Chaitanya110703/AxxSolder/PCB/AxxSolder/AxxSolder.kicad_pcb

## KiCad design PCB/AxxSolder/AxxSolder.kicad_pcb (2023-10-22)

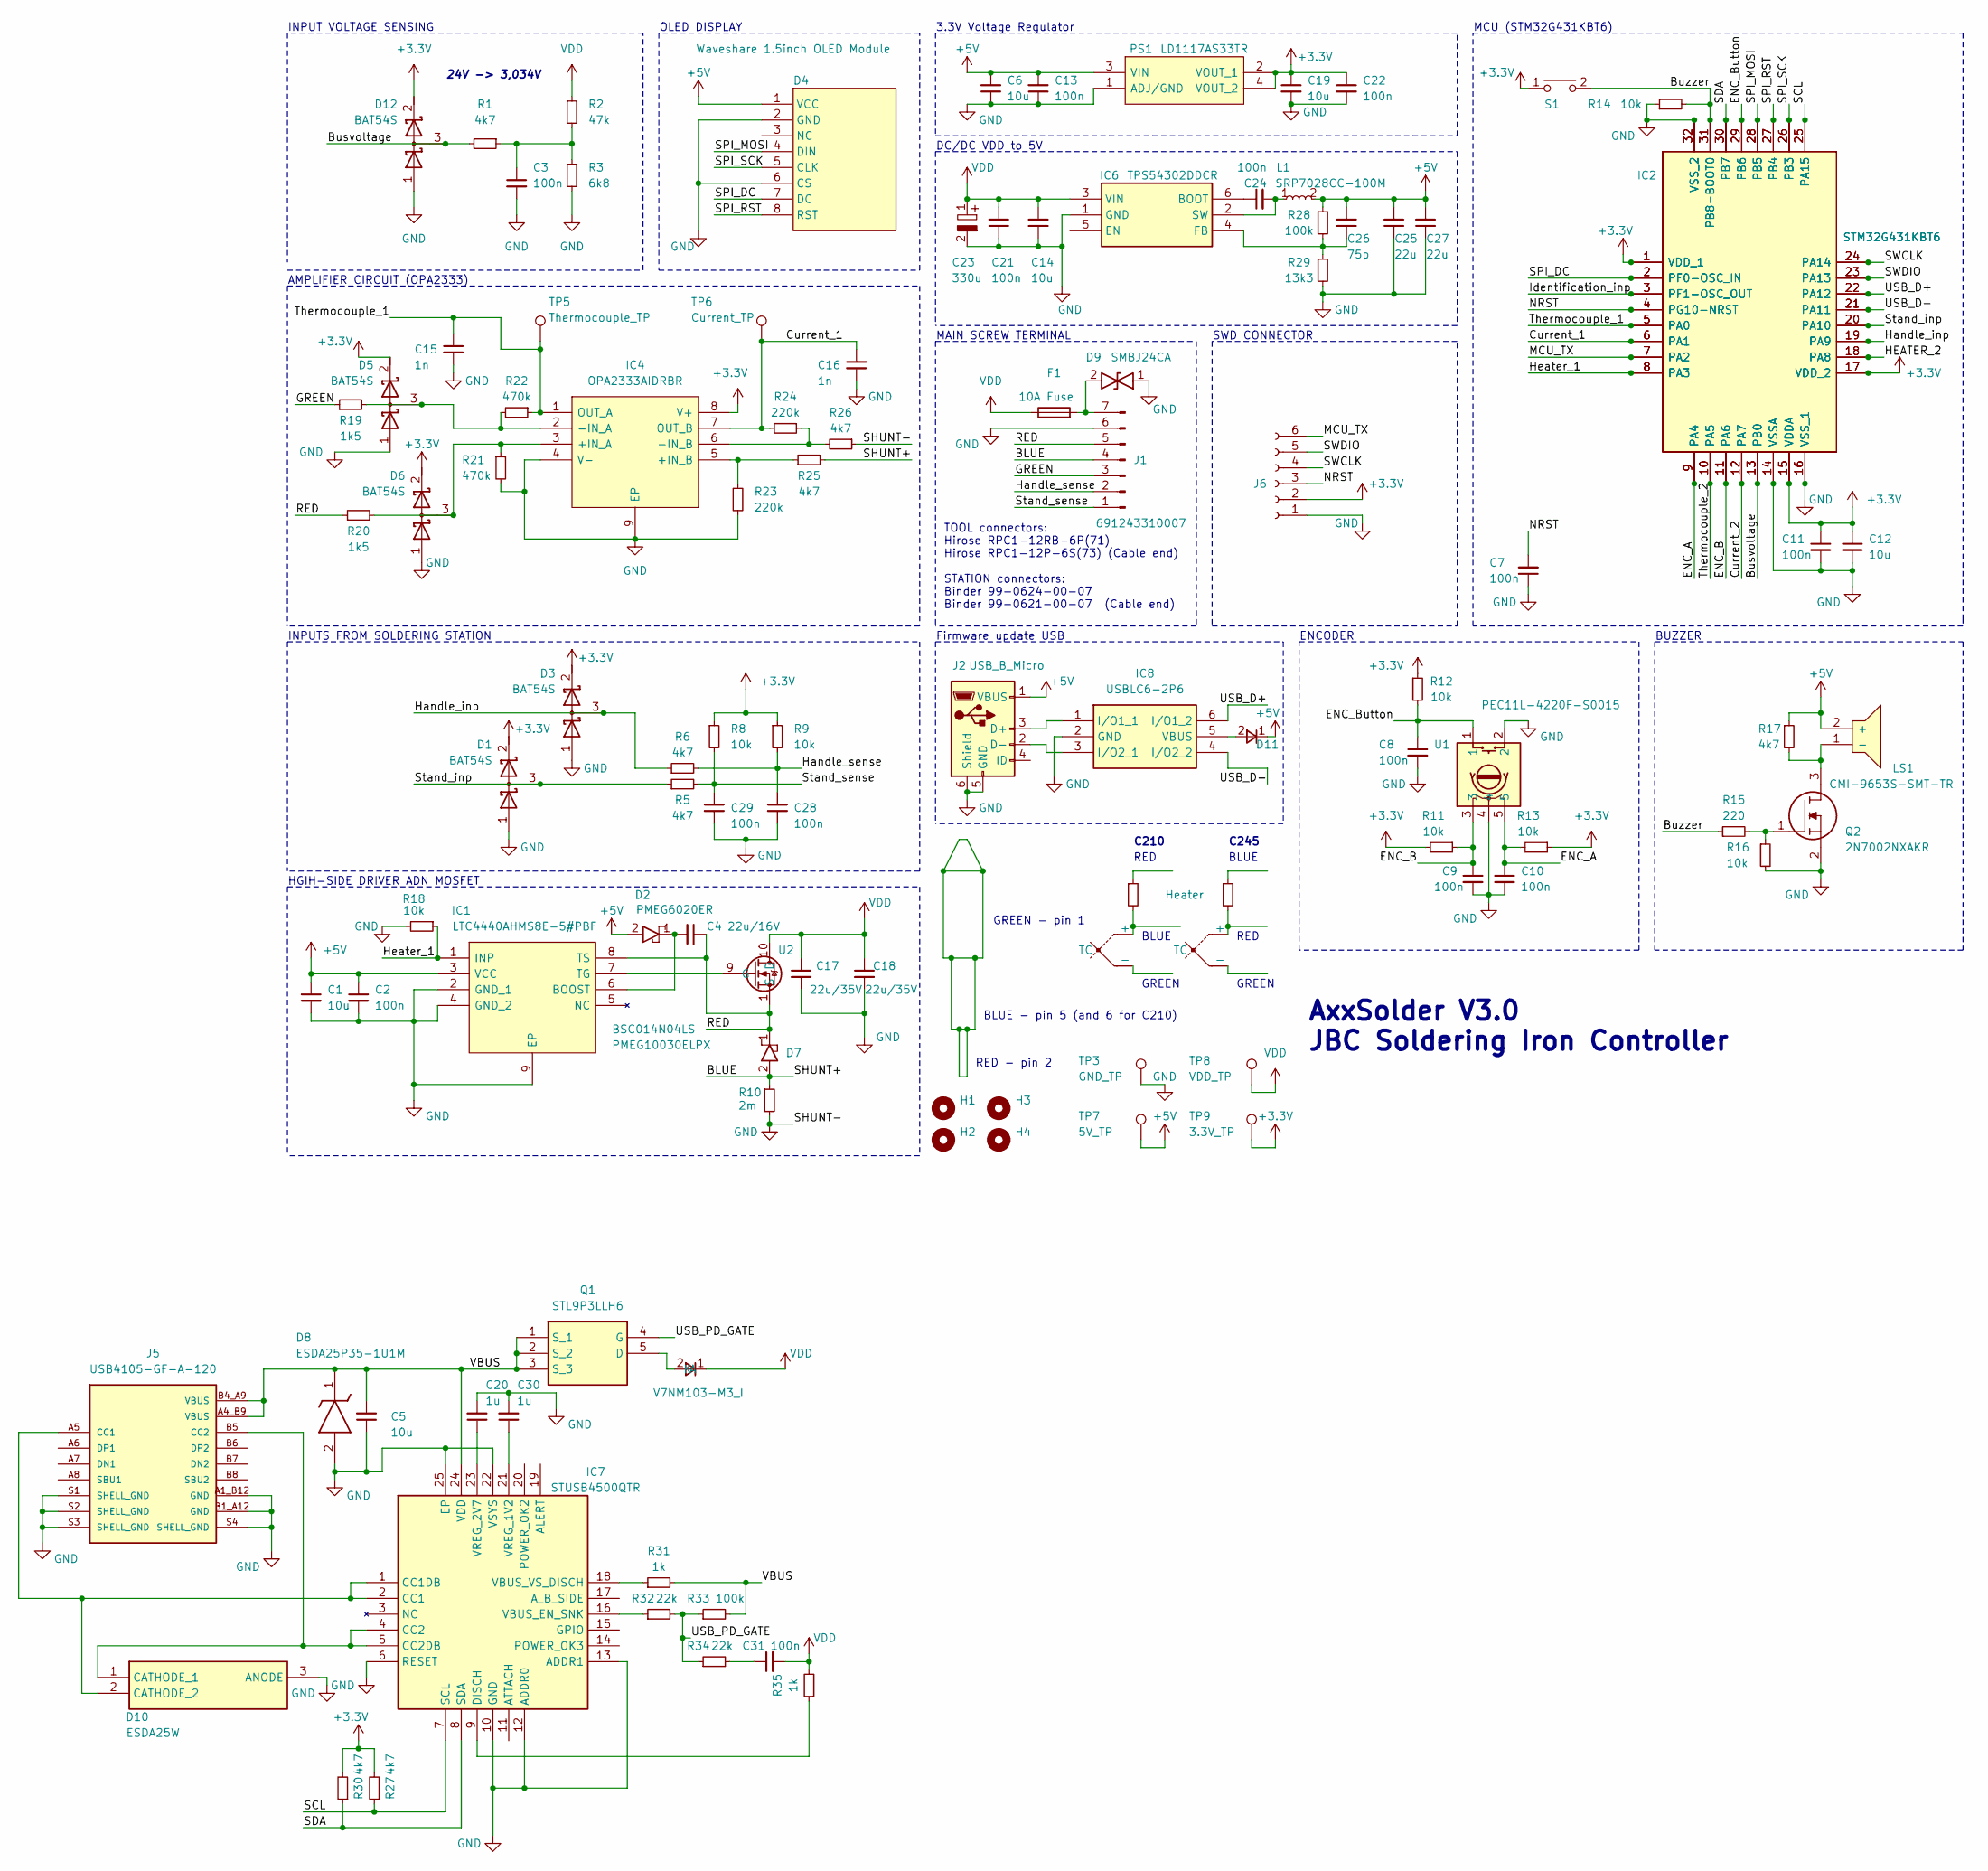
[picture p1: schematic AxxSolder.kicad_sch]

Parts:
C1, C5, C6, C12, C14, C19: 10u; C_0805_2012Metric
C2, C3, C7, C8, C9, C10, C11, C13, C21, C22, C24, C28, C29, C31: 100n; C_0805_2012Metric
C4: 22u/16V; C_1206_3216Metric
C15, C16: 1n; C_0805_2012Metric
C17, C18: 22u/35V; C_1206_3216Metric
C20, C30: 1u; C_0805_2012Metric
C23: 330u; CAPAE1030X1050N; Mouser Part Number 661-EMZR500ARA331MJA
C25, C27: 22u; C_1206_3216Metric
C26: 75p; C_0805_2012Metric
D1, D3, D5, D6, D12: BAT54S; SOT95P230X110-3N
D2: PMEG6020ER; PMEG6020ER115; Mouser Part Number 771-PMEG6020ER-115
D4: Waveshare 1.5inch OLED Module; 1_5inch-rgb-oled-module_asm-1110
D7: PMEG10030ELPX; SODFL4725X110N; Mouser Part Number 771-PMEG10030ELPX
D8: ESDA25P35-1U1M; ESDA25P351U1M; Mouser Part Number 511-ESDA25P35-1U1M
D9: SMBJ24CA; DIOM5436X261N; Mouser Part Number 576-SMBJ24CA
D10: ESDA25W; SOT65P210X110-3N; Mouser Part Number 511-ESDA25W
D11: 1N5819HW-7-F; SOD3716X145N; Mouser Part Number 621-1N5819HW-F
D13: V7NM103-M3_I; V7NM103M3I; Mouser Part Number 625-V7NM103-M3/I
F1: 10A Fuse; 3557-2
H1, H2, H3, H4: MountingHole; MountingHole_3mm
IC1: LTC4440AHMS8E-5#PBF; SOP65P490X110-9N; Mouser Part Number 584-C4440AHMS8E-5PBF
IC2: STM32G431KBT6; QFP80P900X900X160-32N; Mouser Part Number 511-STM32G431KBT6
IC4: OPA2333AIDRBR; SON65P300X300X100-9N-D; Mouser Part Number 595-OPA2333AIDRBR
IC5: STM32G431KBT6; UFQFPN-32-1EP_5x5mm_P0.5mm_EP3.5x3.5mm; Mouser Part Number 511-STM32G431KBT6
IC6: TPS54302DDCR; SOT95P280X110-6N; Mouser Part Number 595-TPS54302DDCR
IC7: STUSB4500QTR; QFN50P400X400X100-25N-D; Mouser Part Number 511-STUSB4500QTR
IC8: USBLC6-2P6; USBLC62P6; Mouser Part Number 511-USBLC6-2P6
J1: Conn_01x07_Male; 691243310007; Manufacturer_Part_Number 691243310007
J2: USB_B_Micro; GCT_USB3140-30-0230-1-C_REVE1
J5: USB4105-GF-A-120; GCT_USB4105-GF-A-120; PARTREV A3
J6: Conn_01x06_Socket; PinSocket_1x06_P2.54mm_Vertical
L1: SRP7028CC-100M; INDPM7366X300N; Manufacturer_Part_Number SRP7028CC-100M
LS1: CMI-9653S-SMT-TR; CMI9653SSMTTR; Mouser Part Number 490-CMI-9653S-SMT-TR
PS1: LD1117AS33TR; SOT230P700X190-4N; Mouser Part Number 511-LD1117AS33
Q1: STL9P3LLH6; STL20N6F7; Mouser Part Number 511-STL9P3LLH6
Q2: 2N7002NXAKR; SOT95P230X110-3N; Manufacturer_Part_Number 2N7002NXAKR; Mouser Part Number 771-2N7002NXAKR
R1, R5, R6, R17, R25, R26, R27, R30: 4k7; R_0805_2012Metric
R2: 47k; R_0805_2012Metric
R3: 6k8; R_0805_2012Metric
R4: Heater
R7: Heater 2 OHM
R8, R9, R11, R12, R13, R14, R16, R18: 10k; R_0805_2012Metric
R10: 2m; RESC6432X89N; part_id WSLP25122L500FEA
R15: 220; R_0805_2012Metric
R19, R20: 1k5; R_0805_2012Metric
R21, R22: 470k; R_0805_2012Metric
R23, R24: 220k; R_0805_2012Metric
R28, R33: 100k; R_0805_2012Metric
R29: 13k3; R_0805_2012Metric
R31, R35: 1k; R_0805_2012Metric
R32, R34: 22k; R_0805_2012Metric
S1: PTS636_SM43_SMTR_LFS; PTS636SM43SMTRLFS; Mouser Part Number 611-PTS636SM43SMTRLF
TC1, TC2: TC
TP3: GND_TP; TestPoint_THTPad_D1.0mm_Drill0.5mm
TP5: Thermocouple_TP; TestPoint_Pad_D1.0mm
TP6: Current_TP; TestPoint_Pad_D1.0mm
TP7: 5V_TP; TestPoint_THTPad_D1.0mm_Drill0.5mm
TP8: VDD_TP; TestPoint_THTPad_D1.0mm_Drill0.5mm
TP9: 3.3V_TP; TestPoint_THTPad_D1.0mm_Drill0.5mm
U1: PEC11L-4220F-S0015; PEC11L4220FS0015; Mouser Part Number 652-PEC11L4220FS0015
U2: BSC014N04LS

Connections:
+3.3V: C11.1, C12.1, C19.1, C22.1, D1.2 (K), D3.2 (K), D5.2 (K), D6.2 (K), D12.2 (K), IC2.1 (VDD_1), IC2.15 (VDDA), IC2.17 (VDD_2), IC4.8 (V+), IC5.1 (VDD_1), IC5.15 (VDDA), IC5.17 (VDD_2), J6.2, PS1.2 (VOUT_1), PS1.4 (VOUT_2), R8.1, R9.1, R11.2, R12.1, R13.1, R27.2, R30.2, S1.1, TP9.1
+5V: C1.1, C2.1, C6.2, C13.2, C25.2, C26.2, C27.2, D2.2, D4.1 (VCC), D11.1, IC1.3 (VCC), J2.1 (VBUS), L1.2, LS1.2 (+), PS1.3 (VIN), R17.1, R28.1, TP7.1
/BLUE: D7.2, J1.4, R10.1, R25.2
/Busvoltage: D12.3 (common), IC2.13 (PB0), IC5.13 (PB0), R1.2
/Buzzer: IC2.31 (PB8-BOOT0), IC5.31 (PB8-BOOT0), R14.2, R15.1, S1.2
/Current_1: C16.1, IC2.6 (PA1), IC4.7 (OUT_B), IC5.6 (PA1), R24.2, TP6.1
/Current_2: IC2.12 (PA7), IC5.12 (PA7)
/ENC_A: C10.1, IC2.9 (PA4), IC5.9 (PA4), R13.2, U1.5
/ENC_B: C9.1, IC2.11 (PA6), IC5.11 (PA6), R11.1, U1.3
/ENC_Button: C8.1, IC2.29 (PB6), IC5.29 (PB6), R12.2, U1.1
/GREEN: J1.3, R19.1
/HEATER_2: IC2.18 (PA8), IC5.18 (PA8)
/Handle_inp: D3.3 (common), IC2.19 (PA9), IC5.19 (PA9), R6.1
/Handle_sense: C28.1, J1.2, R6.2, R9.2
/Heater_1: IC1.1 (INP), IC2.8 (PA3), IC5.8 (PA3), R18.1
/Identification_inp: IC2.3 (PF1-OSC_OUT), IC5.3 (PF1-OSC_OUT)
/MCU_TX: IC2.7 (PA2), IC5.7 (PA2), J6.6
/NRST: C7.2, IC2.4 (PG10-NRST), IC5.4 (PG10-NRST), J6.3
/RED: C4.1, D7.1, IC1.8 (TS), J1.5, R20.1, U2.1 (S)
/SCL: IC2.25 (PA15), IC5.25 (PA15), IC7.7 (SCL), R27.1
/SDA: IC2.30 (PB7), IC5.30 (PB7), IC7.8 (SDA), R30.1
/SPI_DC: D4.7 (DC), IC2.2 (PF0-OSC_IN), IC5.2 (PF0-OSC_IN)
/SPI_MOSI: D4.4 (DIN), IC2.28 (PB5), IC5.28 (PB5)
/SPI_RST: D4.8 (RST), IC2.27 (PB4), IC5.27 (PB4)
/SPI_SCK: D4.5 (CLK), IC2.26 (PB3), IC5.26 (PB3)
/SWCLK: IC2.24 (PA14), IC5.24 (PA14), J6.4
/SWDIO: IC2.23 (PA13), IC5.23 (PA13), J6.5
/Stand_inp: D1.3 (common), IC2.20 (PA10), IC5.20 (PA10), R5.1
/Stand_sense: C29.1, J1.1, R5.2, R8.2
/Thermocouple_1: C15.1, IC2.5 (PA0), IC4.1 (OUT_A), IC5.5 (PA0), R22.1, TP5.1
/Thermocouple_2: IC2.10 (PA5), IC5.10 (PA5)
/USB_D+: IC2.22 (PA12), IC5.22 (PA12), IC8.6 (I/O1_2)
/USB_D-: IC2.21 (PA11), IC5.21 (PA11), IC8.4 (I/O2_2)
/USB_PD_GATE: Q1.4 (G), R32.2, R33.1, R34.1
/VBUS: C5.2, D8.1 (K), IC7.24 (VDD), J5.A4_B9 (VBUS), J5.B4_A9 (VBUS), Q1.1 (S_1), Q1.2 (S_2), Q1.3 (S_3), R31.2, R33.2
GND: C1.2, C2.2, C3.2, C5.1, C6.1, C7.1, C8.2, C9.2, C10.2, C11.2, C12.2, C13.1, C14.1, C15.2, C16.2, C17.2, C18.2, C19.2, C20.2, C21.1, C22.2, C23.2, C25.1, C27.1, C28.2, C29.2, C30.2, D1.1 (A), D3.1 (A), D4.2 (GND), D4.6 (CS), D5.1 (A), D6.1 (A), D8.2 (A), D9.1, D10.3 (ANODE), D12.1 (A), IC1.2 (GND_1), IC1.4 (GND_2), IC1.9 (EP), IC2.14 (VSSA), IC2.16 (VSS_1), IC2.32 (VSS_2), IC4.4 (V-), IC4.9 (EP), IC5.14 (VSSA), IC5.16 (VSS_1), IC5.32 (VSS_2), IC6.1 (GND), IC7.6 (RESET), IC7.10 (GND), IC7.12 (ADDR0), IC7.13 (ADDR1), IC7.22 (VSYS), IC7.25 (EP), IC8.2 (GND), J1.6, J2.5 (GND), J2.6 (Shield), J5.A1_B12 (GND), J5.B1_A12 (GND), J5.S1 (SHELL_GND), J5.S2 (SHELL_GND), J5.S3 (SHELL_GND), J5.S4 (SHELL_GND), J6.1, PS1.1 (ADJ/GND), Q2.2, R3.2, R10.2, R14.1, R16.2, R18.2, R21.2, R23.2, R26.1, R29.2, TP3.1, U1.2, U1.4
unnamed: C3.1, R1.1, R2.2, R3.1
unnamed: C31.1, R34.2
unnamed: D5.3 (common), IC4.2 (-IN_A), R19.2, R22.2
unnamed: D6.3 (common), IC4.3 (+IN_A), R20.2, R21.1
unnamed: D10.1 (CATHODE_1), IC7.4 (CC2), IC7.5 (CC2DB), J5.B5 (CC2)
unnamed: D10.2 (CATHODE_2), IC7.1 (CC1DB), IC7.2 (CC1), J5.A5 (CC1)
unnamed: D13.2 (A), Q1.5 (D)
unnamed: C4.2, D2.1, IC1.6 (BOOST)
unnamed: IC1.7 (TG), U2.9 (G)
unnamed: IC4.5 (+IN_B), R23.1, R25.1
unnamed: IC4.6 (-IN_B), R24.1, R26.2
unnamed: C24.1, IC6.6 (BOOT)
unnamed: C26.1, IC6.4 (FB), R28.2, R29.1
unnamed: C24.2, IC6.2 (SW), L1.1
unnamed: IC7.9 (DISCH), R35.1
unnamed: IC7.16 (VBUS_EN_SNK), R32.1
unnamed: IC7.18 (VBUS_VS_DISCH), R31.1
unnamed: C30.1, IC7.21 (VREG_1V2)
unnamed: C20.1, IC7.23 (VREG_2V7)
unnamed: IC8.1 (I/O1_1), J2.3 (D+)
unnamed: IC8.3 (I/O2_1), J2.2 (D-)
unnamed: D11.2, IC8.5 (VBUS)
unnamed: D9.2, F1.2, J1.7
unnamed: LS1.1 (-), Q2.3, R17.2
unnamed: Q2.1, R15.2, R16.1
unnamed: R4.2, TC1.1 (+)
unnamed: R7.2, TC2.1 (+)
VDD: C14.2, C17.1, C18.1, C21.2, C23.1, C31.2, D13.1 (K), F1.1, IC6.3 (VIN), R2.1, R35.2, TP8.1, U2.10 (D)

Notes on the sheet:
C210
Firmware update USB
MCU (STM32G431KBT6)
C245
GREEN - pin 1
MAIN SCREW TERMINAL
AMPLIFIER CIRCUIT (OPA2333)
24V -> 3,034V
INPUT VOLTAGE SENSING
ENCODER
SWD CONNECTOR
BLUE
BLUE - pin 5 (and 6 for C210)
GREEN
RED
BUZZER
DC/DC VDD to 5V
AxxSolder V3.0 JBC Soldering Iron Controller
TOOL connectors: Hirose RPC1-12RB-6P(71) Hirose RPC1-12P-6S(73) (Cable end) STATION connectors: Binder 99-0624-00-07 Binder 99-0621-00-07 (Cable end)
INPUTS FROM SOLDERING STATION
HGIH-SIDE DRIVER ADN MOSFET
RED - pin 2
RED
3.3V Voltage Regulator
OLED DISPLAY

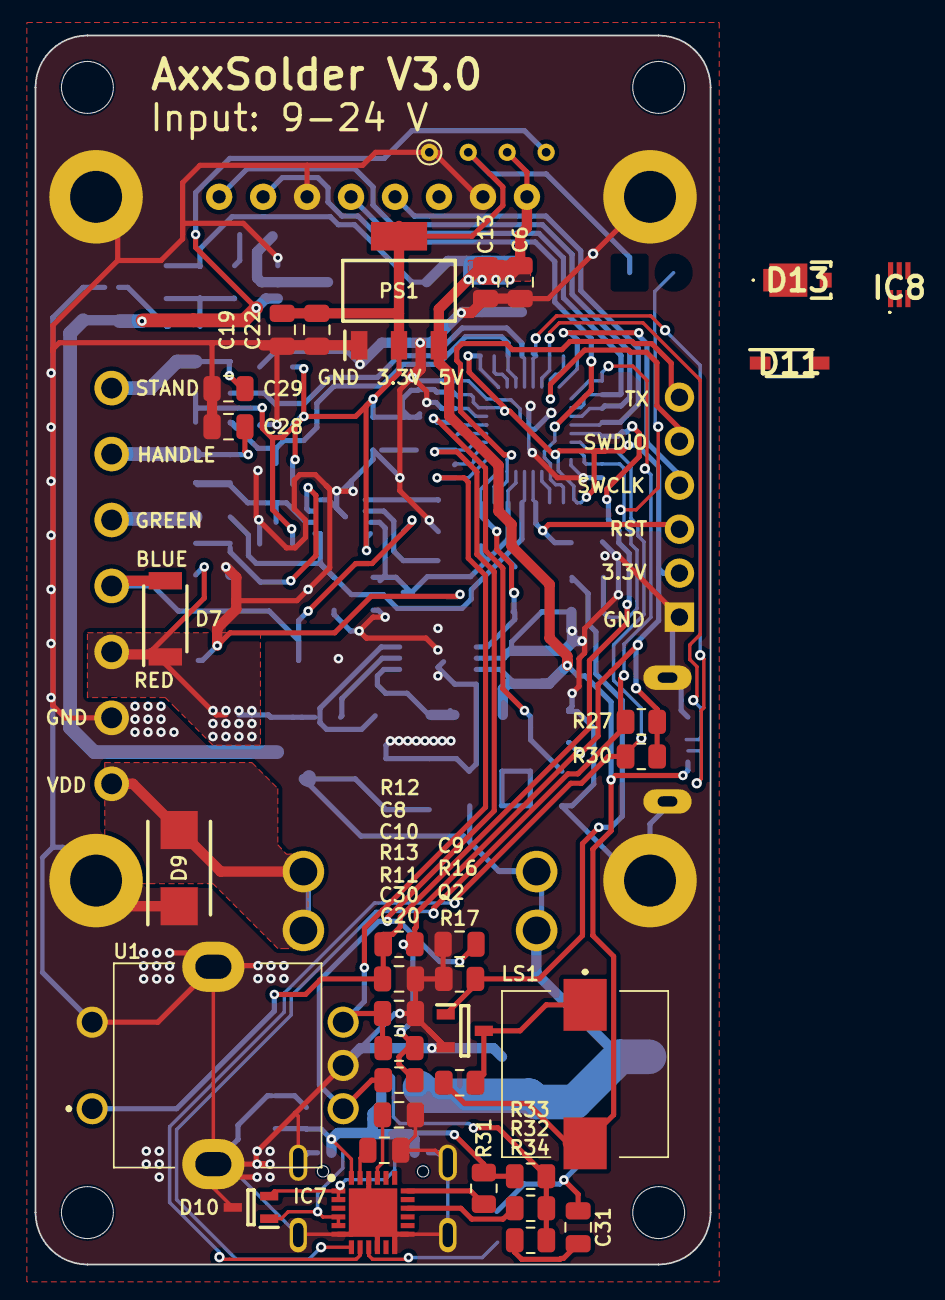
[picture p2: board AxxSolder.kicad_pcb from above]

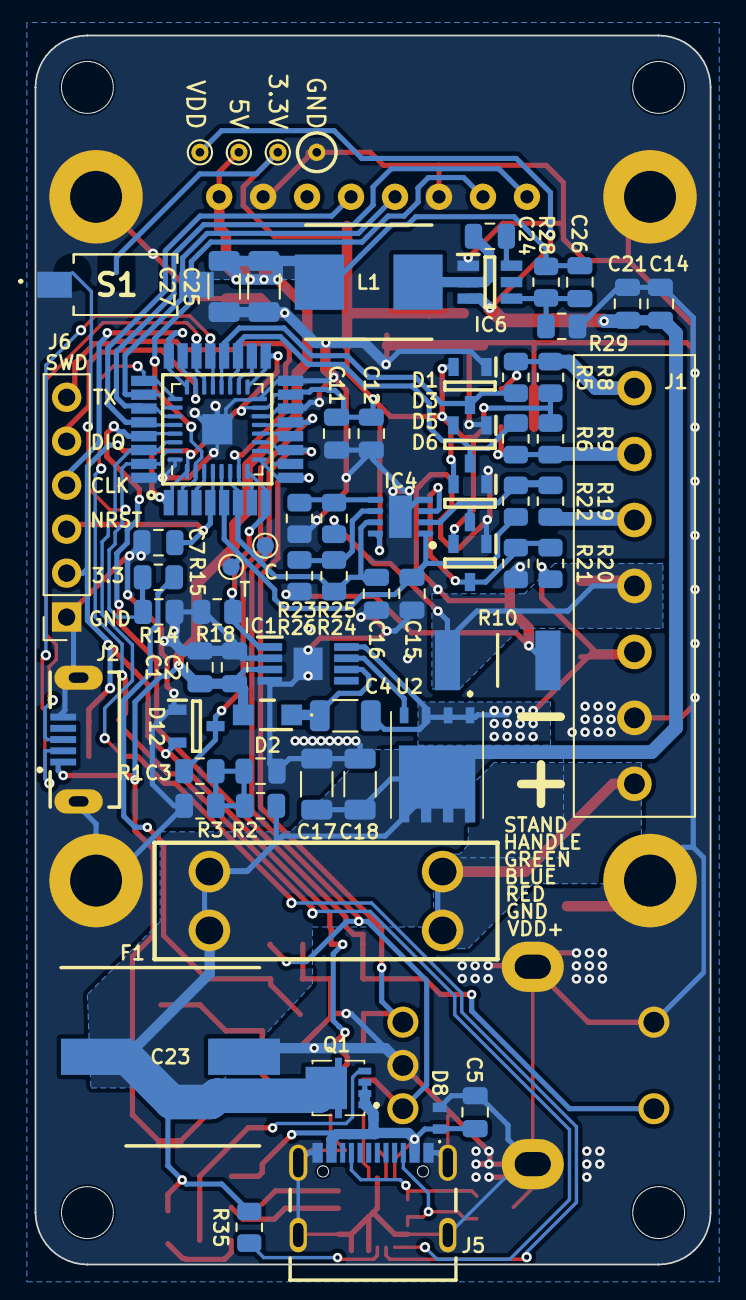
[picture p3: board AxxSolder.kicad_pcb from below]

Board: 2 copper layers, 39.0 x 71.0 mm, 107 parts (68 on the bottom side), 62 nets.
