Chaitanya110703/AxxSolder/Software/AxxSolder/Core/Src/main.c

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
/* Includes ------------------------------------------------------------------*/
#include "main.h"

/* USER CODE BEGIN Includes */
#include "string.h"
#include "OLED_1in5.h"
#include "test.h"
#include "pid.h"
#include "moving_average.h"
/* USER CODE END Includes */

/* USER CODE BEGIN PTD */

#define version "2.2.0"

enum handles {
	T210,
	T245
} handle;

uint8_t beep_requested = 0;							/* Bool to handle beep signal triggered by interrupt */

/* Create a new image cache */
UBYTE *black_image;
UWORD image_size = ((OLED_1in5_WIDTH%2==0)? (OLED_1in5_WIDTH/2): (OLED_1in5_WIDTH/2+1)) * OLED_1in5_HEIGHT;

/* Timing constants */
uint32_t previous_millis_display = 0;
uint32_t interval_display = 25;

uint32_t previous_millis_debug = 0;
uint32_t interval_debug = 50;

uint32_t previous_millis_PID_update = 0;
uint32_t interval_PID_update = 50;

uint32_t previous_millis_HANDLE_update = 0;
uint32_t interval_HANDLE_update = 200;

uint32_t previous_millis_heating_halted_update = 0;
uint32_t interval_heating_halted_update = 500;

uint32_t previous_millis_left_stand = 0;
uint32_t EMERGENCY_shutdown_time = 1800000; 	//30 minutes
uint32_t EMERGENCY_shutdown_temperature = 475;  //475 Deg C

/* states for runtime switch */
typedef enum {
    RUN,
	SLEEP,
	EMERGENCY_SLEEP,
	HALTED,
} mainstates;
mainstates active_state = SLEEP;

/* Custom tuning parameters */
double Kp_custom = 0;
double Ki_custom = 0;
double Kd_custom = 0;
double temperature_custom = 100;

/* PID tuning parameters */
double Kp = 0;
double Ki = 0;
double Kd = 0;

char buffer[40];								/* Buffer for UART print */
uint8_t tx_done = 1;

#define POWER_REDUCTION_FACTOR 0.12 			/* Converts power in W to correct duty cycle */
float max_power_watt = 0.0; 					/* Sets the maximum output power */

float ADC_filter_mean = 0.0; 					/* Filtered ADC reading value */
#define ADC_BUF_LEN 400
uint16_t ADC_buffer[ADC_BUF_LEN];

#define VOLTAGE_COMPENSATION 0.00648678945 		/* Constant for scaling input voltage ADC value*/

#define MIN_SELECTABLE_TEMPERTURE 20
#define MAX_SELECTABLE_TEMPERTURE 450

/* TC Compensation constants */
#define TC_COMPENSATION_X3_T210 -6.798689261365103e-09
#define TC_COMPENSATION_X2_T210 -6.084684965926526e-06
#define TC_COMPENSATION_X1_T210 0.2710175613404393
#define TC_COMPENSATION_X0_T210 25.398999666765054

#define TC_COMPENSATION_X3_T245 2.0923844111330006e-09
#define TC_COMPENSATION_X2_T245 -1.2139133328964936e-05
#define TC_COMPENSATION_X1_T245 0.11753371673595008
#define TC_COMPENSATION_X0_T245 25.051871505499836


#define AMBIENT_TEMP_COMPENSATION 0.0008058608 /* Ambient temperature compensation constant 3.3/4095 */

/* Struct to hold sensor values */
struct sensor_values_struct {
	double set_temperature;
	double actual_temperature;
	float bus_voltage;
	float pcb_temperature;
	float ambient_temperature;
	double in_stand;
	double handle_sense;
	mainstates previous_state;
	uint8_t button_pressed;
	uint8_t button_read;
};

struct sensor_values_struct sensor_values  = {.set_temperature = 0.0,
        									.actual_temperature = 0.0,
											.bus_voltage = 0.0,
											.pcb_temperature = 0.0,
											.ambient_temperature = 0.0,
											.in_stand = 0.0,
											.handle_sense  = 0.0,
											.previous_state = SLEEP,
											.button_pressed = 0,
											.button_read = 0};

double PID_output = 0.0;
double PID_setpoint = 0.0;

/* Moving average filters for sensor data */
FilterTypeDef actual_temperature_filter_struct;
FilterTypeDef ambient_temperature_filter_struct;
FilterTypeDef input_voltage_filterStruct;
FilterTypeDef stand_sense_filterStruct;
FilterTypeDef handle_sense_filterStruct;

/* USER CODE END PTD */

 ADC_HandleTypeDef hadc1;
ADC_HandleTypeDef hadc2;
DMA_HandleTypeDef hdma_adc1;

I2C_HandleTypeDef hi2c1;

SPI_HandleTypeDef hspi1;

TIM_HandleTypeDef htim1;
TIM_HandleTypeDef htim2;
TIM_HandleTypeDef htim3;
TIM_HandleTypeDef htim8;
TIM_HandleTypeDef htim16;
TIM_HandleTypeDef htim17;

UART_HandleTypeDef huart2;

PCD_HandleTypeDef hpcd_USB_FS;

void SystemClock_Config(void);
static void MX_GPIO_Init(void);
static void MX_DMA_Init(void);
static void MX_TIM2_Init(void);
static void MX_SPI1_Init(void);
static void MX_ADC1_Init(void);
static void MX_TIM17_Init(void);
static void MX_USART2_UART_Init(void);
static void MX_TIM3_Init(void);
static void MX_TIM16_Init(void);
static void MX_I2C1_Init(void);
static void MX_ADC2_Init(void);
static void MX_TIM1_Init(void);
static void MX_TIM8_Init(void);
static void MX_USB_PCD_Init(void);
/* USER CODE BEGIN 0 */

PID_TypeDef TPID;

void HAL_UART_TxCpltCallback(UART_HandleTypeDef *UartHandle){
	/* Set transmission flag: transfer complete */
	tx_done = 1;
}

/* Returns the average of 100 readings of the index+4*n value in the ADC_buffer vector */
float get_mean_ADC_reading(uint8_t index){
	ADC_filter_mean = 0;
	for(int n=index;n<400;n=n+4){
		ADC_filter_mean += ADC_buffer[n];
	}
	return ADC_filter_mean/100.0;
}

void get_bus_voltage(){
	/* Index 3 is bus Voltage */
	sensor_values.bus_voltage = Moving_Average_Compute(get_mean_ADC_reading(3), &input_voltage_filterStruct)*VOLTAGE_COMPENSATION; /* Moving average filter */
}

void get_actual_temperature(){
	/* Index 0 is bus Voltage */
	float TC_temperature_temp = Moving_Average_Compute(get_mean_ADC_reading(0), &actual_temperature_filter_struct); /* Moving average filter */
	if(handle == T210){
		sensor_values.actual_temperature = pow(TC_temperature_temp, 3)*TC_COMPENSATION_X3_T210 +
				pow(TC_temperature_temp, 2)*TC_COMPENSATION_X2_T210 + TC_temperature_temp*TC_COMPENSATION_X1_T210 + TC_COMPENSATION_X0_T210;
	}
	else if(handle == T245){
		sensor_values.actual_temperature = pow(TC_temperature_temp, 3)*TC_COMPENSATION_X3_T245 +
				pow(TC_temperature_temp, 2)*TC_COMPENSATION_X2_T245 + TC_temperature_temp*TC_COMPENSATION_X1_T245 + TC_COMPENSATION_X0_T245;
	}

	if(sensor_values.actual_temperature > 999){
		sensor_values.actual_temperature = 999;
	}
}

void get_ambient_temp(){
	//Index 2 is PCB temp
	/* Moving average filter */
	sensor_values.ambient_temperature = ((Moving_Average_Compute(get_mean_ADC_reading(2), &ambient_temperature_filter_struct)*AMBIENT_TEMP_COMPENSATION)-0.4)/0.0195;
	//• Positive slope sensor gain, offset (typical):
	//– 19.5 mV/°C, 400 mV at 0°C (TMP236-Q1) From data sheet
}

void debugPrint(UART_HandleTypeDef *huart, char _out[]){
    tx_done = 0;
	HAL_UART_Transmit_IT(huart, (uint8_t *) _out, strlen(_out));
	while(!tx_done);
}

/* Initiate OLED display */
void init_OLED(){
	OLED_1in5_Init();
	Driver_Delay_ms(500);
	OLED_1in5_Clear();

	//0.Create a new image cache
	if((black_image = (UBYTE *)malloc(image_size)) == NULL) {
		return;
	}
	Paint_NewImage(black_image, OLED_1in5_WIDTH, OLED_1in5_HEIGHT, 270, BLACK);
	Paint_SetScale(16);

	//1.Select Image
	Paint_SelectImage(black_image);
	Paint_Clear(BLACK);
	Driver_Delay_ms(200);
}

void update_OLED(){
	Paint_DrawString_EN(0, 0, " AxxSolder ", &Font16, 0x00, 0xff);
    Paint_DrawLine(0, 16, 127, 16, WHITE , 2, LINE_STYLE_SOLID);

	Paint_DrawString_EN(3, 20, "Set temp", &Font16, 0x00, 0xff);
	memset(&buffer, '\0', sizeof(buffer));
	sprintf(buffer, "%.f", sensor_values.set_temperature);
	Paint_DrawString_EN(3, 32, buffer, &Font24,  0x0, 0xff);
	Paint_DrawCircle(67, 37, 2, WHITE, 1, DRAW_FILL_EMPTY);
	Paint_DrawString_EN(70, 32, "C", &Font24,  0x0, 0xff);

	Paint_DrawString_EN(3, 58, "Act temp", &Font16, 0x00, 0xff);
	memset(&buffer, '\0', sizeof(buffer));

	if(sensor_values.actual_temperature >= 500){
		Paint_DrawString_EN(3, 70, "---", &Font24, 0x0, 0xff);
	}
	else{
		sprintf(buffer, "%.f", sensor_values.actual_temperature);
		Paint_DrawString_EN(3, 70, buffer, &Font24, 0x0, 0xff);
	}

	Paint_DrawCircle(67, 75, 2, WHITE, 1, DRAW_FILL_EMPTY);
	Paint_DrawString_EN(70, 70, "C", &Font24, 0x0, 0xff);
	Paint_DrawRectangle(1, 56, 100, 93 , WHITE, DOT_PIXEL_1X1, DRAW_FILL_EMPTY);

	Paint_DrawString_EN(0, 96, "HANDLE:", &Font12, 0x00, 0xff);
	if(handle == T210){
		Paint_DrawString_EN(60, 96, "T210", &Font12, 0x00, 0xff);
	}
	else if(handle == T245){
		Paint_DrawString_EN(60, 96, "T245", &Font12, 0x00, 0xff);
	}

	Paint_DrawString_EN(0, 109, "INPUT VOLTAGE:", &Font8, 0x00, 0xff);
	Paint_DrawString_EN(0, 118, "AMB TEMP:     POWER ->", &Font8, 0x00, 0xff);

	memset(&buffer, '\0', sizeof(buffer));
	sprintf(buffer, "%.1f", sensor_values.bus_voltage);
	Paint_DrawString_EN(75, 109, buffer, &Font8, 0x0, 0xff);

	memset(&buffer, '\0', sizeof(buffer));
	sprintf(buffer, "%.1f", sensor_values.ambient_temperature);
	Paint_DrawString_EN(45, 118, buffer, &Font8, 0x0, 0xff);

	Paint_DrawRectangle(116, 25, 128, 128, WHITE, DOT_PIXEL_1X1, DRAW_FILL_EMPTY);
	if(active_state == SLEEP || active_state == EMERGENCY_SLEEP || active_state == HALTED){
		Paint_DrawString_EN(116, 30,  "Z", &Font16, 0x00, 0xff);
		Paint_DrawString_EN(116, 50,  "z", &Font16, 0x00, 0xff);
		Paint_DrawString_EN(116, 70,  "Z", &Font16, 0x00, 0xff);
		Paint_DrawString_EN(116, 90,  "z", &Font16, 0x00, 0xff);
		Paint_DrawString_EN(116, 110, "z", &Font16, 0x00, 0xff);
	}
	else{
		Paint_DrawRectangle(116, 125-PID_output/10, 128, 128, WHITE, DOT_PIXEL_1X1, DRAW_FILL_FULL);
	}
	// Show image on page
	OLED_1in5_Display(black_image);
	Paint_Clear(BLACK);
}

/* Get encoder value (Set temp.) and limit is NOT heating_halted*/
void get_set_temperature(){
	if (TIM3->CNT <= MIN_SELECTABLE_TEMPERTURE) {TIM3->CNT = MIN_SELECTABLE_TEMPERTURE; }
	if (TIM3->CNT >= MAX_SELECTABLE_TEMPERTURE) {TIM3->CNT = MAX_SELECTABLE_TEMPERTURE; }
	sensor_values.set_temperature = TIM3->CNT;
}

/* Beep the buzzer for beep_time_ms */
void beep_ms(uint16_t beep_time_ms){
	TIM2->CCR1 = 50;
  	HAL_Delay(beep_time_ms);
  	TIM2->CCR1 = 0;
}

/* Create a beep is beep is requested */
void check_beep(){
	if(beep_requested){
		beep_ms(5);
		beep_requested = 0;
	}
}

/* Function to set state to EMERGENCY_SLEEP */
void check_emergency_shutdown(){
	/* Function to set state to EMERGENCY_SLEEP if iron is in RUN state for longer than EMERGENCY_shutdown_time */
	if(!sensor_values.previous_state == RUN  && active_state == RUN){
		previous_millis_left_stand = HAL_GetTick();
	}
	if ((sensor_values.in_stand == 0) && (HAL_GetTick() - previous_millis_left_stand >= EMERGENCY_shutdown_time) && active_state == RUN){
		active_state = EMERGENCY_SLEEP;
		beep_requested = 1;
	}
	sensor_values.previous_state = active_state;

	/* Function to set state to EMERGENCY_SLEEP if iron is over 500 deg C */
	if((sensor_values.actual_temperature > EMERGENCY_shutdown_temperature) && (active_state == RUN)){
		active_state = EMERGENCY_SLEEP;
		beep_requested = 1;
	}
}

/* Function to toggle between RUN and HALTED at each press of the encoder button */
void get_button_status(){
	if ((sensor_values.button_pressed == 1) && (sensor_values.button_read == 0)){
		sensor_values.button_read = 1;
		beep_requested = 1;
		// toggle between RUN and HALTED
		if (active_state == RUN){
			active_state = HALTED;
		}
		else if (active_state == HALTED){
			active_state = RUN;
		}
		else if (active_state == EMERGENCY_SLEEP){
			active_state = RUN;
		}
		previous_millis_heating_halted_update = HAL_GetTick();
	}
	if ((sensor_values.button_read == 1) && (HAL_GetTick()-previous_millis_heating_halted_update >= interval_heating_halted_update)){
		sensor_values.button_pressed = 0;
		sensor_values.button_read = 0;
	}
}

/* Get the status of handle in/on stand to trigger SLEEP */
void get_stand_status(){
	uint8_t stand_status;
	if(HAL_GPIO_ReadPin (GPIOA, STAND_INP_Pin) == 0){
		stand_status = 1;
	}
	else{
		stand_status = 0;
	}
	sensor_values.in_stand = Moving_Average_Compute(stand_status, &stand_sense_filterStruct); /* Moving average filter */

	/* If handle is in stand set state to SLEEP */
	if(sensor_values.in_stand > 0.5){
		active_state = SLEEP;
	}

	/* If handle is NOT in stand and state is SLEEP, change state to RUN */
	if((sensor_values.in_stand < 0.5) && (active_state == SLEEP)){
		active_state = RUN;
	}
}

/* Automatically detect handle type, T210 or T245 based on HANDLE_DETECTION_Pin, which is connected to BLUE for T210.*/
void get_handle_type(){
	uint8_t handle_status;
	if(HAL_GPIO_ReadPin (GPIOA, HANDLE_INP_Pin) == 0){
		handle_status = 1;
	}
	else{
		handle_status = 0;
	}
	sensor_values.handle_sense = Moving_Average_Compute(handle_status, &handle_sense_filterStruct); /* Moving average filter */

	/* If the handle_sense is high -> T210 handle is detected */
	if(sensor_values.handle_sense > 0.5){
		handle = T210;
		max_power_watt = 60; //60W
		Kp = 20;
		Ki = 60;
		Kd = 0.5;
	}
	/* If the handle_sense is low -> T245 Handle */
	else{
		handle = T245;
		max_power_watt = 120; //120W
		Kp = 30;
		Ki = 60;
		Kd = 1;
	}
	PID_SetTunings(&TPID, Kp, Ki, Kd); // Update PID parameters based on handle type
}

/* Called when buffer is completely filled, used for DEBUG */
//void HAL_ADC_ConvCpltCallback(ADC_HandleTypeDef* hadc) {
//    //HAL_GPIO_TogglePin(GPIOF, DEBUG_SIGNAL_A_Pin);
//}

/* Interrupts when encoder button is pressed */
void HAL_GPIO_EXTI_Callback(uint16_t GPIO_Pin){
    if(GPIO_Pin == ENC_BUTTON_Pin && !sensor_values.button_pressed){ // If The INT Source Is EXTI Line9 (A9 Pin)
    	sensor_values.button_pressed = 1;
    }
}

/* Interrupts at every encoder increment */
void HAL_TIM_IC_CaptureCallback(TIM_HandleTypeDef *htim){
	if (htim->Channel == HAL_TIM_ACTIVE_CHANNEL_1) {
		beep_requested = 1;
	}
}

/* Sets the duty cycle of timer controlling the heater */
void set_heater_duty(uint16_t dutycycle){
	TIM17->CCR1 = dutycycle;
}
/* USER CODE END 0 */

/**
  * @brief  The application entry point.
  * @retval int
  */
int main(void)
{
  /* MCU Configuration--------------------------------------------------------*/

  /* Reset of all peripherals, Initializes the Flash interface and the Systick. */
  HAL_Init();

  /* Configure the system clock */
  SystemClock_Config();

  /* Initialize all configured peripherals */
  MX_GPIO_Init();
  MX_DMA_Init();
  MX_TIM2_Init();
  MX_SPI1_Init();
  MX_ADC1_Init();
  MX_TIM17_Init();
  MX_USART2_UART_Init();
  MX_TIM3_Init();
  MX_TIM16_Init();
  MX_I2C1_Init();
  MX_ADC2_Init();
  MX_TIM1_Init();
  MX_TIM8_Init();
  MX_USB_PCD_Init();
  /* USER CODE BEGIN 2 */
	HAL_TIM_Encoder_Start_IT(&htim3, TIM_CHANNEL_ALL);
	HAL_TIM_PWM_Start(&htim17, TIM_CHANNEL_1);
	HAL_TIM_PWM_Start(&htim2, TIM_CHANNEL_1);
	HAL_ADCEx_Calibration_Start(&hadc1, ADC_SINGLE_ENDED);
	HAL_ADC_Start_DMA(&hadc1, (uint32_t*)ADC_buffer, ADC_BUF_LEN);	//Start ADC DMA

	Moving_Average_Init(&actual_temperature_filter_struct,5);
	Moving_Average_Init(&ambient_temperature_filter_struct,200);
	Moving_Average_Init(&input_voltage_filterStruct,200);
	Moving_Average_Init(&stand_sense_filterStruct,200);
	Moving_Average_Init(&handle_sense_filterStruct,200);

  /* USER CODE END 2 */

  /* Infinite loop */
  /* USER CODE BEGIN WHILE */

	/* Init and fill filter structures with initial values */
	set_heater_duty(0);
	for (int i = 0; i<200;i++){
		get_bus_voltage();
		get_ambient_temp();
		get_actual_temperature();
		get_handle_type();
		get_stand_status();
	}

	/* Start-up beep */
	beep_ms(10);
	HAL_Delay(100);
	beep_ms(10);

	/* Initiate OLED display */
	init_OLED();

	/* If button is pressed during startup - Show SETTINGS and allow to release button. */
	if (HAL_GPIO_ReadPin (GPIOA, ENC_BUTTON_Pin) == 0){
		Paint_DrawString_EN(0, 0, " SETTINGS ", &Font16, 0x00, 0xff);
		Paint_DrawLine(0, 16, 127, 16, WHITE , 2, LINE_STYLE_SOLID);
		OLED_1in5_Display(black_image);
		Paint_Clear(BLACK);
		HAL_Delay(1000);

		while(HAL_GPIO_ReadPin (GPIOA, ENC_BUTTON_Pin) == 1){
			Paint_DrawString_EN(0, 0, " SETTINGS ", &Font16, 0x00, 0xff);
			Paint_DrawLine(0, 16, 127, 16, WHITE , 2, LINE_STYLE_SOLID);

			Paint_DrawString_EN(3, 20, "Coming soon...", &Font12, 0x00, 0xff);
			Paint_DrawString_EN(0, 110, "Version: ", &Font12, 0x00, 0xff);
			Paint_DrawString_EN(60, 110, version, &Font12, 0x00, 0xff);

			OLED_1in5_Display(black_image);
			Paint_Clear(BLACK);
		}
	}

	/* Set initial encoder timer value */
	TIM3->CNT = 330;

	/* Startup beep */
	beep_ms(10);

	/* Initiate PID controller */
	PID(&TPID, &sensor_values.actual_temperature, &PID_output, &PID_setpoint, Kp, Ki, Kd, _PID_P_ON_E, _PID_CD_DIRECT);
	PID_SetMode(&TPID, _PID_MODE_AUTOMATIC);
	PID_SetSampleTime(&TPID, 50);
	PID_SetOutputLimits(&TPID, 0, 1000); 	// Set max and min output limit
	PID_SetILimits(&TPID, -200, 200); 		// Set max and min I limit

	while (1){
		get_stand_status();
		get_bus_voltage();
		get_handle_type();
		get_button_status();
		get_set_temperature();
		check_beep();
		check_emergency_shutdown();

		/* switch */
		switch (active_state) {
			case EMERGENCY_SLEEP: {
				PID_setpoint = 0;
				break;
			}
			case RUN: {
				PID_setpoint = sensor_values.set_temperature;
				break;
			}
			case SLEEP: {
				PID_setpoint = 0;
				break;
			}
			case HALTED: {
				PID_setpoint = 0;
				break;
			}
		}

		if(HAL_GetTick() - previous_millis_PID_update >= interval_PID_update){
			set_heater_duty(0);
			HAL_Delay(10); // Wait to let the thermocouple voltage stabilize before taking measurement
			get_actual_temperature();
			previous_millis_PID_update = HAL_GetTick();
		}

		// TUNING - ONLY USED DURING MANUAL PID TUNING
		// ----------------------------------------------
		//PID_SetTunings(&TPID, Kp_custom, Ki_custom, Kd_custom);
		//sensor_values.set_temperature = temperature_custom;
		// ----------------------------------------------

		/* Compute PID and set duty cycle */
		PID_Compute(&TPID);
		set_heater_duty(PID_output*(max_power_watt*POWER_REDUCTION_FACTOR/sensor_values.bus_voltage));

		/* Send debug information over serial */
		if(HAL_GetTick() - previous_millis_debug >= interval_debug){
			memset(&buffer, '\0', sizeof(buffer));
			sprintf(buffer, "%3.1f\t%3.1f\t%3.1f\t%3.1f\t%3.1f\t%3.1f\t%3.1f\t%3.1f\n",
					sensor_values.actual_temperature, sensor_values.set_temperature,
					PID_output/10, PID_GetPpart(&TPID)/10, PID_GetIpart(&TPID)/10, PID_GetDpart(&TPID)/10,
					sensor_values.in_stand*50, sensor_values.handle_sense*50)
					;
			debugPrint(&huart2,buffer);
			previous_millis_debug = HAL_GetTick();
		}

		/* Update display */
		if(HAL_GetTick() - previous_millis_display >= interval_display){
			get_ambient_temp();
			update_OLED();
			previous_millis_display = HAL_GetTick();
		}

    /* USER CODE END WHILE */

    /* USER CODE BEGIN 3 */
	}
  /* USER CODE END 3 */
}

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
