Chaitanya110703/AxxSolder/Software/AxxSolder/AxxSolder.ioc

Mcu.UserName=STM32G431KBTx
PA0.GPIO_Label=THERMOCOUPLE_1
PA0.Signal=ADC1_IN1
PA1.GPIO_Label=CURRENT_1
PA1.Signal=ADC1_IN2
PA10.GPIO_Label=STAND_INP
PA10.Signal=GPIO_Input
PA11.Signal=USB_DM
PA12.Signal=USB_DP
PA13.GPIO_Label=T_SWDIO
PA13.Signal=SYS_JTMS-SWDIO
PA14.GPIO_Label=T_SWCLK
PA14.Signal=SYS_JTCK-SWCLK
PA15.Signal=I2C1_SCL
PA2.Signal=USART2_TX
PA3.GPIO_Label=HEATER_1
PA3.Signal=S_TIM2_CH4
PA4.Signal=S_TIM3_CH2
PA5.GPIO_Label=THERMOCOUPLE_2
PA5.Signal=ADC2_IN13
PA6.Signal=S_TIM3_CH1
PA7.GPIO_Label=CURRENT_2
PA7.Signal=ADC2_IN4
PA8.GPIO_Label=HEATER_2
PA8.Signal=S_TIM1_CH1
PA9.GPIO_Label=HANDLE_INP
PA9.Signal=GPIO_Input
PB0.GPIO_Label=BUSVOLTAGE
PB0.Signal=ADC1_IN15
PB3.Signal=SPI1_SCK
PB4.GPIO_Label=SPI_RST
PB4.Signal=GPIO_Output
PB5.Signal=SPI1_MOSI
PB6.GPIO_Label=ENC_BUTTON
PB6.Signal=GPXTI6
PB7.Signal=I2C1_SDA
PB8-BOOT0.GPIO_Label=BUZZER
PB8-BOOT0.Signal=S_TIM8_CH2
PF0-OSC_IN.GPIO_Label=SPI_DC
PF0-OSC_IN.Signal=GPIO_Output
PF1-OSC_OUT.GPIO_Label=IDENTIFICATION_INP
PF1-OSC_OUT.Signal=ADC2_IN10
