Chaitanya110703/AxxSolder/(commit log)

2023-10-20 add libraries and import components for USB firmware upload and USB PD
    [AxxSolder.kicad_pcb, AxxSolder.kicad_sch]
2023-10-21 update for USB support
    [AxxSolder.kicad_pcb, AxxSolder.kicad_sch]
2023-10-22 Update to PCB
    [AxxSolder.kicad_pcb, AxxSolder.kicad_sch]
