Chaitanya110703/AxxSolder/(notices)

Notices in the files:
Software/AxxSolder/Core/Inc/main.h:
Copyright (c) 2023 STMicroelectronics.
All rights reserved.
This software is licensed under terms that can be found in the LICENSE file
Software/AxxSolder/Core/Src/main.c:
Copyright (c) 2023 Axel Johansson
